coulston/Embedded-Systems-Instructor/hardware/daughterBoard/readme.md

# Ordering Process for Daughter Boards
Image of Embedded Development Daughter Board

This file outlines a procedure to order development boards from [JLCPCB](https://www.jlcpcb.com/).  
>[!NOTE] 
>These instructions referece manufacturer web pages that are not under my control.  As a 
result the web interfaces may be modified changing the look and feel of the interface.  In this
event, you will need to adapt the instructions to the current interface.

## Order from JLCPCB

1. Download [daughterBoardGerber.zip](Https://github.com/coulston/Embedded-Systems-Instructor/blob/main/hardware/daughterBoard/manufacture/daughterBoardGerber.zip) to your local drive
5. Sign In to [JLCPCB](https://www.jlcpcb.com/).
6. Click on the white Order Now button at the top of the page
7. Click on the blue Add gerber files button
8. In the pop-up, navigate and select daughterBoardGerber.zip you downloaded
9. Leave all the defaults along with the exception:
   - Quantity: Whatever you need
   - PCB Color: Blue has been the standard color
10. Click on the blue Add to Cart button
11. Click on the shopping cart icon at the top of the screen
12. Click the blue Secure Checkout button and proceed with payment and shipping.
13. You should hear back from the JLCPCB in 24 hours.
