coulston/Embedded-Systems-Instructor/hardware/devBoard/img/pcbWay05.PNG

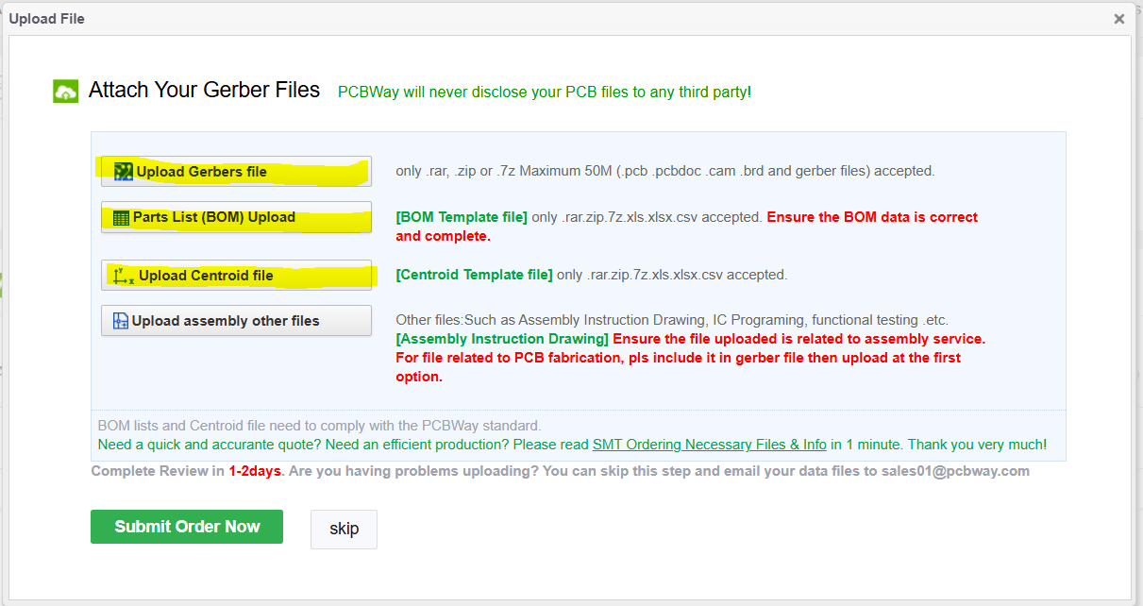
hardware/devBoard/img/pcbWay05.PNG
