coulston/Embedded-Systems-Instructor/hardware/devBoard/manufacture/devBoard BOM.xlsx

Value | Designator | Manufacture | Mnf Part # | Digikey Part | Foot |  | Number | SMT | Through | #SMT | #through
2.2 ohm | R2, R10 | Yageo | RC1206FR-072R2L | 311-2.20FRCT-ND | R1206 | $0.05 | 2 | 1 |  | 2 | 0
39 ohm | R1, R4, R13 | Panasonic | ERJ-8GEYJ390V | P39ECT-ND | R1206 | $0.03 | 3 | 1 |  | 3 | 0
100 ohms | R12 | Panasonic | ERJ-8GEYJ101V | P100ECT-ND | R1206 | $0.03 | 1 | 1 |  | 1 | 0
300 ohm | R8 | Panasonic | ERJ-8GEYJ301V | P300ECT-ND | R1206 | $0.03 | 1 | 1 |  | 1 | 0
910 ohm | R11, R14, R22 | Panasonic | ERJ-8GEYJ911V | P910ECT-ND | R1206 | $0.03 | 3 | 1 |  | 3 | 0
2.2k ohm | R3, R15, R16 | Panasonic | ERJ-8GEYJ222V | P2.20KFCT-ND | R1206 | $0.03 | 3 | 1 |  | 3 | 0
10k ohm | R5, R6, R7, R18, R19, R20, R21, R23 | Vishay Dale | CRCW120610K0FKEAC | 541-3983-1-ND | R1206 | $0.03 | 8 | 1 |  | 8 | 0
1M ohm | R9 | Panasonic | ERJ-8GEYJ105V | P1.0MECT-ND | R1206 | $0.03 | 1 | 1 |  | 1 | 0
 |  |  |  |  |  |  |  |  |  | 0 | 0
PTC fuse | F2 | LittleFuse | 1206L012WR | F2864CT-ND | R1206 | $0.33 | 1 | 1 |  | 1 | 0
47pF | C2, C4, C13 | Kemet | C1206C470K5GACTU | 399-8191-1-ND | C1206 | $0.06 | 3 | 1 |  | 3 | 0
0.1uF | C3, C5, C6, C8, C11, C14, C16, C17, C18 | Samsung | CL31B104KBCNNNC | 1276-1017-1-ND | C1206 | $0.03 | 9 | 1 |  | 9 | 0
1uF | C10, C15, C19 | Samsung | CL31B105KOFNNNE | 1276-1783-1-ND | C1206 | $0.05 | 3 | 1 |  | 3 | 0
10uF | C1, C7, C9, C12 | Samsung | CL31A106KQHNNNE | 1276-1079-1-ND | C1206 | $0.05 | 4 | 1 |  | 4 | 0
 |  |  |  |  |  |  |  |  |  | 0 | 0
M02LOCK | 5V, JP2, JP7, JP3 | Molex | 901200122 | WM8072-ND | 0.1" header | $0.78 | 4 |  | 1 | 0 | 4
M03LOCK | JP4 | Molex | 901200123 | WM8073-ND | 0.1" header | $0.78 | 1 |  | 1 | 0 | 1
M06LOCK | JP10, JP12 | Molex | 901200126 | WM8076-ND | 0.1" header | $0.74 | 2 |  | 1 | 0 | 2
Right | JP11 | FCI | 22288061 | WM50025-06-ND | 0.1" header | $1.14 | 1 |  | 1 | 0 | 1
Mini USB conn | X1 | Tyco | 1734035-2 | A31727CT-ND | Custom | $1.40 | 1 | 1 |  | 1 | 0
2x4 header | JP8, JP9 | FCI | 67997-108HLF | 609-3226-ND | 2x4 | $0.36 | 2 |  | 1 | 0 | 2
Tactile Switch SPST-NO Top Actuated Surface Mount | BOT, RESET, TOP | C&K | PTS526 SMG15 SMTR2 LFS | CKN12222-1-ND | 5.2mm | $0.08 | 3 | 1 |  | 3 | 0
Electric Mic | MICROPHONE | CUI | CMA-6542PF | 102-1720-ND | 9.7mm | $0.53 | 1 |  | 1 | 0 | 1
Terminal Block | SPEAKER | Phoenix Contact | part# 1725656 | 277-1273-ND | Custom | $1.47 | 1 |  | 1 | 0 | 1
 |  |  |  |  |  |  |  |  |  | 0 | 0
PIC 18F25K22 | PIC18F25K22 | Microchips | PIC18F25K22-I/SS | PIC18F25K22-I/SS-ND | 28-SSOP | $2.18 | 1 | 1 |  | 1 | 0
Serial USB bridge | IC2 | Future Tech | FT230XS-R | 768-1135-1-ND | 16-SSOP | $1.90 | 1 | 1 |  | 1 | 0
GP Opamp | IC1, IC4 | Texas | OPA344NA/250 | OPA344NACT-ND | SOT23-5 | $1.05 | 2 | 1 |  | 2 | 0
2N2222 NPN | Q1 | Diodes Incorporated | MMBT2222A-7-F | MMBT2222A-FDICT-ND | SOT-23 | $0.05 | 1 | 1 |  | 1 | 0
Linear Voltage Regulator IC 1 Output 250mA SOT-23A-3 | MCP1703 | Microchips | MCP1703T-3302E/CB | MCP1703T-3302E/CBCT-ND | SOT-23 | $0.41 | 1 | 1 |  | 1 | 0
Audio Amp | IC6 | TI | LM4862MX/NOPB | LM4862MX/NOPBCT-ND | 8 SOIC | $0.83 | 1 | 1 |  | 1 | 0
38kHz remote | IR1 | Vishay | TSOP34438 | TSOP34438-ND | custom | $0.70 | 1 | 1 |  | 1 | 0
Green SM | LED3 | Lite-On | LTST-C150GKT | 160-1169-1-ND | D1206 | $0.11 | 1 | 1 |  | 1 | 0
Red SM | LED6 | Lumex | SML-LX1206SRC-TR | 67-1359-1-ND | D1206 | $0.12 | 1 | 1 |  | 1 | 0
IR LED | LED5 | OSRAM | SFH 4045N | 475-3047-6-ND | D1206 | $0.37 | 1 | 1 |  | 1 | 0
RGB LED | LED4 | Cree | CLVBA-FKA-CAEDH8BBB7A363 | CLVBA-FKA-CAEDH8BBB7A363CT-ND | 4-PLCC | $0.36 | 1 | 1 |  | 1 | 0
Hall Effect | IC3 | Texas | DRV5053CAQDBZT | 296-46086-1-ND | SOT-23-3 | $0.86 | 1 | 1 |  | 1 | 0
 |  | 34 |  |  |  |  | 71 |  |  | 59 | 12
