coulston/Embedded-Systems-Instructor/hardware/devBoard/manufacture/devBoard BOM JLC.xlsx

Comment | Designator | Footprint | Part | Quantity
2.2 ohm | R2, R10 | 1206R | C2907445 | 1
39 ohm | R1, R4, R13 | 1206R | C25379 | 1
100 ohms | R12 | 1206R | C17901 | 1
300 ohm | R8 | 1206R | C17887 | 1
910 ohm | R11, R14, R22 | 1206R | C2930433 | 1
2.2k ohm | R3, R15, R16 | 1206R | C17948 | 1
10k ohm | R5, R6, R7, R18, R19, R20, R21, R23 | 1206R | C17902 | 1
1M ohm | R9 | 1206R | C17927 | 1
PTC fuse | F2 | 1206R | C883127 | 1
47pF | C2, C4, C13 | 1206C | C5137553 | 1
0.1uF | C3, C5, C6, C8, C11, C14, C16, C17, C18 | 1206C | C24497 | 1
1uF | C10, C15, C19 | 1206C | C1848 | 1
10uF | C1, C7, C9, C12 | 1206C | C13585 | 1
Tactile Switch SPST-NO Top Actuated Surface Mount | BOT, RESET, TOP | 5.2*5.2 | C5342990 | 1
USB | X1 | Custom | C91144 | 1
PIC 18F25K22 | PIC18F25K22 | SSOP-28 | C51680 | 1
Serial USB bridge | IC2 | SSOP-16 | C69082 | 1
GP Opamp | IC1, IC4 | SOT23-5 | C131974 | 1
2N2222 NPN | Q1 | SOT-23 |  | 1
Linear Voltage Regulator IC 1 Output 250mA SOT-23A-3 | MCP1703 | SOT-23 | C50754 | 1
Audio Amp | IC6 | SOIC-8 | C2860743 | 1
Green SM | LED3 | 1206D | C2984261 | 1
Red SM | LED6 | 1206D | C2984261 | 1
IR LED | LED5 | 1206D |  | 1
RGB LED | LED4 | PLCC-4 | C5355897 | 1
Hall Effect | IC3 | SOT-23-3 | C962159 | 1
