coulston/Embedded-Systems-Instructor/hardware/daughterBoard/manufacture/daughterBoard BOM.xlsx

Sheet: Digikey
DigiKey Order
Description | Manf | Manf Part # | DigiKey Part # | Foot | Unit Cost | Per Qty | Per Student | Bulk | Qty Need | Inventory | Order | Net Cost
1k ohm | Vishay Dale | CRCW12061K00FKEAC | 541-3980-1-ND | R1206 | $0.03 | 4 | $0.10 |  | 12 |  | 12 | $0.31
10k ohm | Vishay Dale | CRCW120610K0FKEAC | 541-3983-1-ND | R1206 | $0.03 | 3 | $0.08 |  | 9 |  | 9 | $0.25
0.1uF | Samsung | CL31B104JBCNNNC | 1276-1165-1-ND | C1206 | $0.03 | 1 | $0.03 |  | 3 |  | 3 | $0.10
10uF | Samsung | CL31A106KQHNNNE | 1276-1079-1-ND | C1206 | $0.05 | 1 | $0.05 |  | 3 |  | 3 | $0.15
Tactile Switch SPST-NO Top Actuated Surface Mount | C&K | PTS526 SMG15 SMTR2 LFS | CKN12222-1-ND | Custom | $0.10 | 3 | $0.31 |  | 9
Slide Switch SP3T Surface Mount, Right Angle | C&K | AYZ0103AGRLC | 401-2014-1-ND | Custom | $0.84 | 1 | $0.84 |  | 3 |  | 3 | $2.52
CONN HDR 6POS 0.1 TIN PCB | Sullins Connector Solutions | PPTC061LFBN-RC | S7004-ND | 6 pos header | $0.37 | 2 | $0.74 |  | 6 |  | 6 | $2.22
CONN HDR 8POS 0.1 TIN PCB | Sullins Connector Solutions | PPTC042LFBN-RC | S7072-ND | 2x4 pos header | $0.51 | 2 | $1.01 |  | 6 |  | 6 | $3.04
Spacer | Essentra Components | 13RS025092 | 145-13RS025092-ND | Custom | $0.07 | 3 | $0.21 |  | 9 |  | 9 | $0.62
#4-40 Pan Head Machine Screw Slotted Drive Steel | B&F Fastener Supply | PMS 440 0063 SL | H148-ND | 4-40 screw | $0.01 | 3 | $0.03 |  | 9
#4-40 Hex Nut 0.250" (6.35mm) 1/4" | B&F Fastener Supply | HNZ 440 | H216-ND | 4-40 nut | $0.01 | 3 | $0.03 |  | 9
Connector Header Surface Mount, Right Angle 2 position 0.079" (2.00mm) | JST Sales America Inc. | S2B-PH-SM4-TB(LF)(SN) | 455-1749-6-ND | JST2 | $0.45 | 1
Green SM | Lite-On | LTST-C150GKT | 160-1169-1-ND | D1206 | $0.11 | 2 | $0.22 |  | 6 |  | 6 | $0.65
Yellow | Lite-On | LTST-C150KSKT | 160-1406-1-ND | D1206 | $0.11 | 1 | $0.11 |  | 3 |  | 3 | $0.33
Red SM | Lite-On | LTST-C150CKT | 160-1167-1-ND | D1206 | $0.12 | 1 | $0.12 |  | 3 |  | 3 | $0.37
Linear Voltage Regulator IC Positive Fixed 1 Output 150mA SOT-23-5 | Micrel | MIC5205-3.3YM5 TR | 576-1259-1-ND | SOT23-5 | $0.42 | 1
Linear Voltage Regulator IC Positive Fixed 1 Output 200mA SOT-23 | Torex Semiconductor Ltd | XC6206P332MR-G | XC6206P332MR-G-ND | SOT23
 |  | MCP73831
Charger IC Lithium Ion TSOT-23-5 | Analog Devices Inc. | LTC4054ES5-4.2#TRMPBF | LTC4054ES5-4.2#TRMPBFCT-ND | SOT23-5 | $2.87 | 1
Charger IC Lithium Ion TSOT-23-5 | STMicroelectronics | STC4054GR | 497-5809-1-ND | SOT23-5 | $1.20 | 1
GY521 |  |  |  |  |  | 1
Purchase | 3 |  | Parts |  | $3.89 | 1 | $3.89 |  | 3 |  | 3 | $10.25

Sheet: AliExpress
DigiKey Order
Description | Manf | Pcs / Order | Foot | Cost | Per Qty | Per Student | Inventory | Order | Net Cost
2.2k ohm | link (https://www.aliexpress.com/item/32847115923.html?spm=a2g0o.detail.1000023.6.4ccc5890SBA9vw) | 100 | R1206 | $0.45 | 9 | $0.04 |  | 18 | $8.10
10uF | link (https://www.aliexpress.com/item/4001289480699.html) | 100 | C1206 | $1.35 | 2 | $0.03 |  | 4 | $5.40
Tactile Switch SPST-NO Top Actuated Surface Mount H=2.3 | link (https://www.aliexpress.com/item/1068215251.html) | 50 | Custom | $0.88 | 3 | $0.05 |  | 12 | $10.56
Slide Switch SP3T Surface Mount, Right Angle | link (https://www.aliexpress.com/item/1005002974022339.html) | 100 | Custom | $3.84 | 1 | $0.04 |  | 2 | $7.68
CONN HDR 2POS 0.1 TIN PCB | link (https://www.aliexpress.com/item/32392631192.html) | 100 | 2 pos header | $9.50 | 1 | $0.10 |  | 2 | $19.00
CONN HDR 6POS 0.1 TIN PCB | link (https://www.aliexpress.com/item/32392631192.html) | 100 | 6 pos header | $10.30 | 2 | $0.21 |  | 4 | $41.20
CONN HDR 8POS 0.1 TIN PCB | link (https://www.aliexpress.com/item/32982421676.html) | 50 | 2x4 pos header | $1.52 | 1 | $0.03 |  | 4 | $6.08
Spacer 11mm, M3, White | link (https://www.aliexpress.com/item/32955606430.html) | 50 | Custom | $4.40 | 3 | $0.26 |  | 12 | $52.80
M3 screw, white 5mm | link (https://www.aliexpress.com/item/32967298736.html?pdp_ext_f=%7B%22sku_id%22%3A%2266645096831%22%7D) | 50 | M3 screw | $0.68 | 3 | $0.04 |  | 12 | $8.16
M3 nut white | link (https://www.aliexpress.com/item/32855383443.html) | 100 | M3 nut | $2.56 | 3 | $0.08 |  | 6 | $15.36
Green SM | link (https://www.aliexpress.com/item/2031685194.html?pdp_ext_f=%7B%22sku_id%22%3A%2265106616640%22%7D) | 100 | D1206 | $0.60 | 3 | $0.02 |  | 6 | $3.60
Yellow | link (https://www.aliexpress.com/item/2031685194.html?pdp_ext_f=%7B%22sku_id%22%3A%2265106616640%22%7D) | 100 | D1206 | $0.60 | 1 | $0.01 |  | 2 | $1.20
Red SM | link (https://www.aliexpress.com/item/2031685194.html?pdp_ext_f=%7B%22sku_id%22%3A%2265106616640%22%7D) | 100 | D1206 | $0.60 | 1 | $0.01 |  | 2 | $1.20
MCP73831T-2DCI/OT | link (https://www.aliexpress.com/item/32958433167.html?pdp_ext_f=%7B%22sku_id%22%3A%2266415343963%22%7D) | 100 | SOT23-5 | $5.10 | 1 | $0.05 |  | 1 | $5.10
GY521 | link (https://www.aliexpress.com/item/1005001864385331.html?scm_id=1007.33416.213724.0&scm-url=1007.33416.213724.0) | 10 | Custom | $11.20 | 1 | $1.12 |  | 20 | $224.00
2pin JST | link (https://www.aliexpress.com/item/1005003221061447.html) | 100 | Custom | $28.00 | 1 | $0.28 |  | 2 | $56.00
H36 3.7v 150mah 30C LIPO Battery | link (https://www.aliexpress.com/item/4000146593141.html) | 100 | Custom | $107.68 | 1 | $1.08 |  | 2 | $215.36
Purchase |  |  |  | $3.43 | 1 | $3.43 |  |  | $672.70
200
