coulston/Embedded-Systems-Instructor/hardware/devBoard/testing/img/PXL_20230522_024632017.jpg

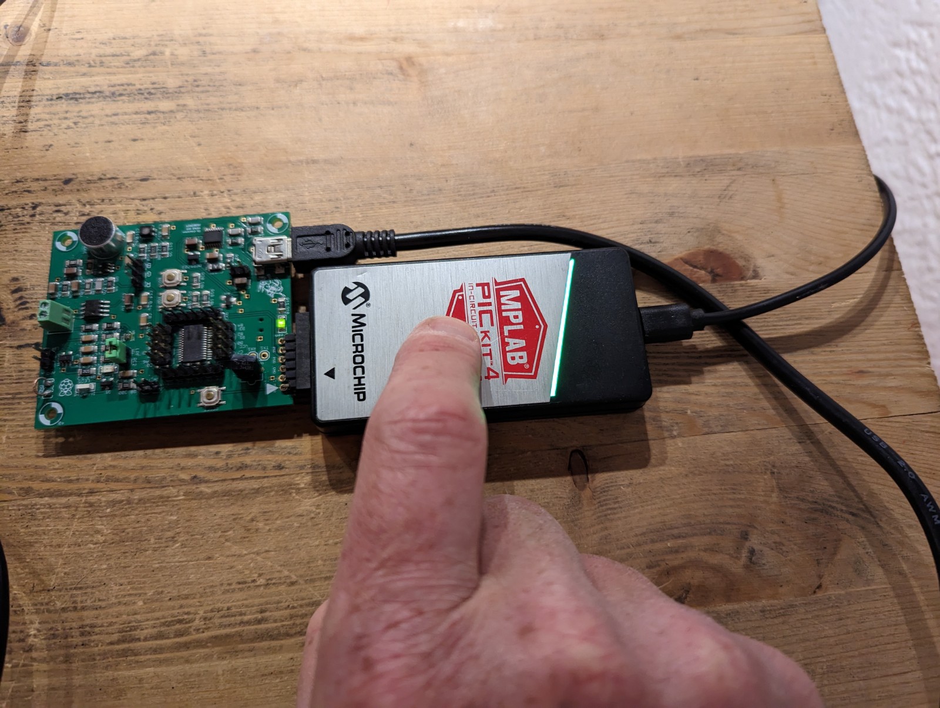
hardware/devBoard/testing/img/PXL_20230522_024632017.jpg
