coulston/Embedded-Systems-Instructor/hardware/devBoard/testing/img/PXL_20230522_025110916.jpg

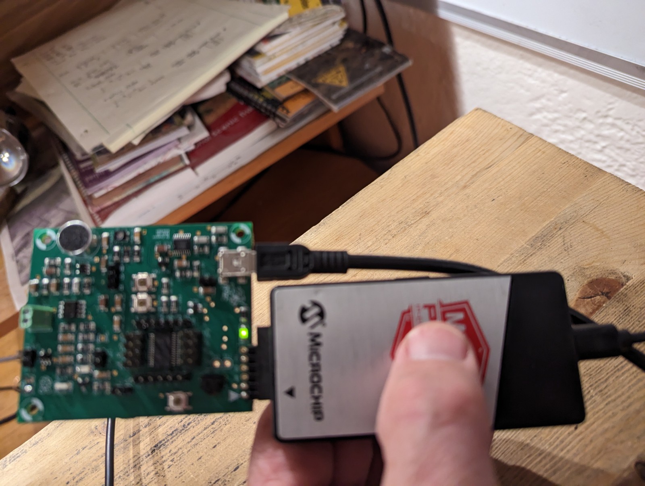
hardware/devBoard/testing/img/PXL_20230522_025110916.jpg
