coulston/Embedded-Systems-Instructor/hardware/devBoard/testing/img/PXL_20230522_025114191.jpg

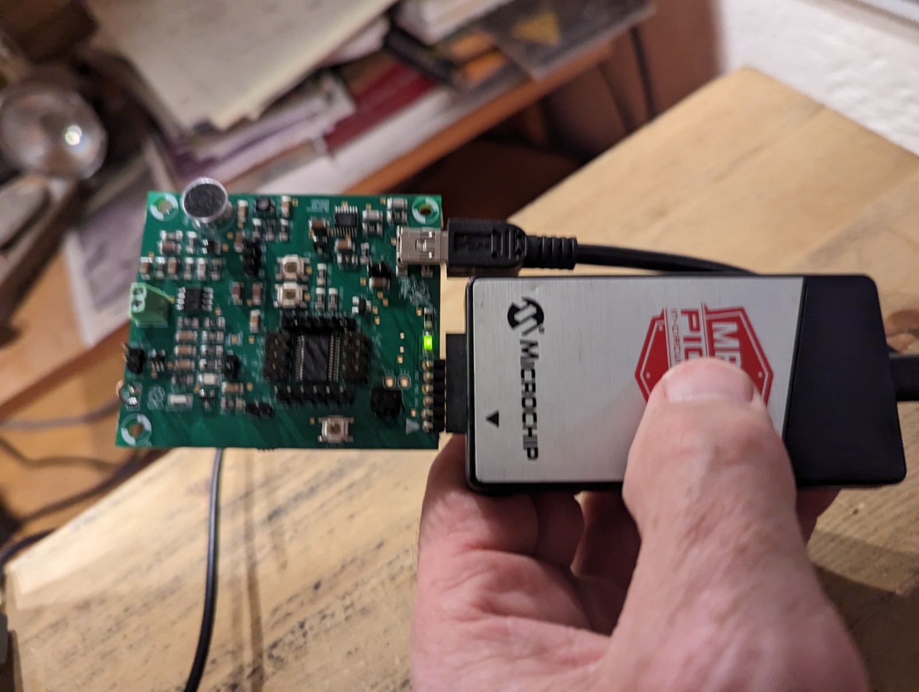
hardware/devBoard/testing/img/PXL_20230522_025114191.jpg
