coulston/Embedded-Systems-Instructor/hardware/devBoard/src/dev21schematic.pdf

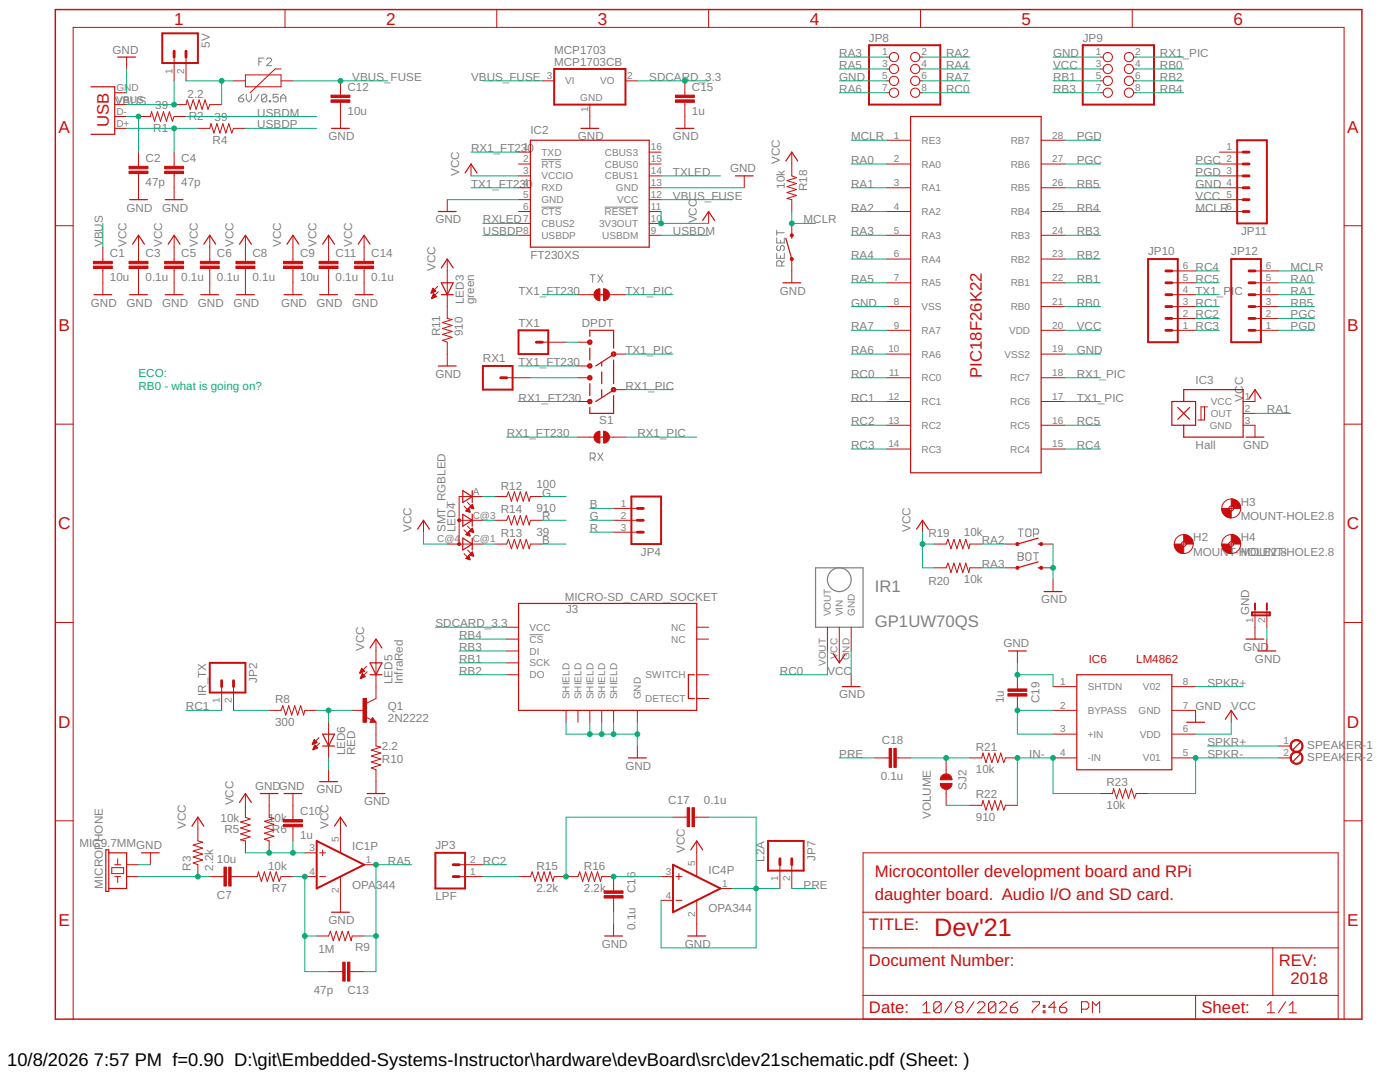
[picture p28: page 1]

ECO: RB0 - what is going on?

Microcontoller development board and RPi
Dev'21

10/8/2026 7:57 PM f=0.90 D:\git\Embedded-Systems-Instructor\hardware\devBoard\src\dev21schematic.pdf (Sheet: )
