coulston/Embedded-Systems-Instructor/hardware/devBoard/src/dev21layout.pdf

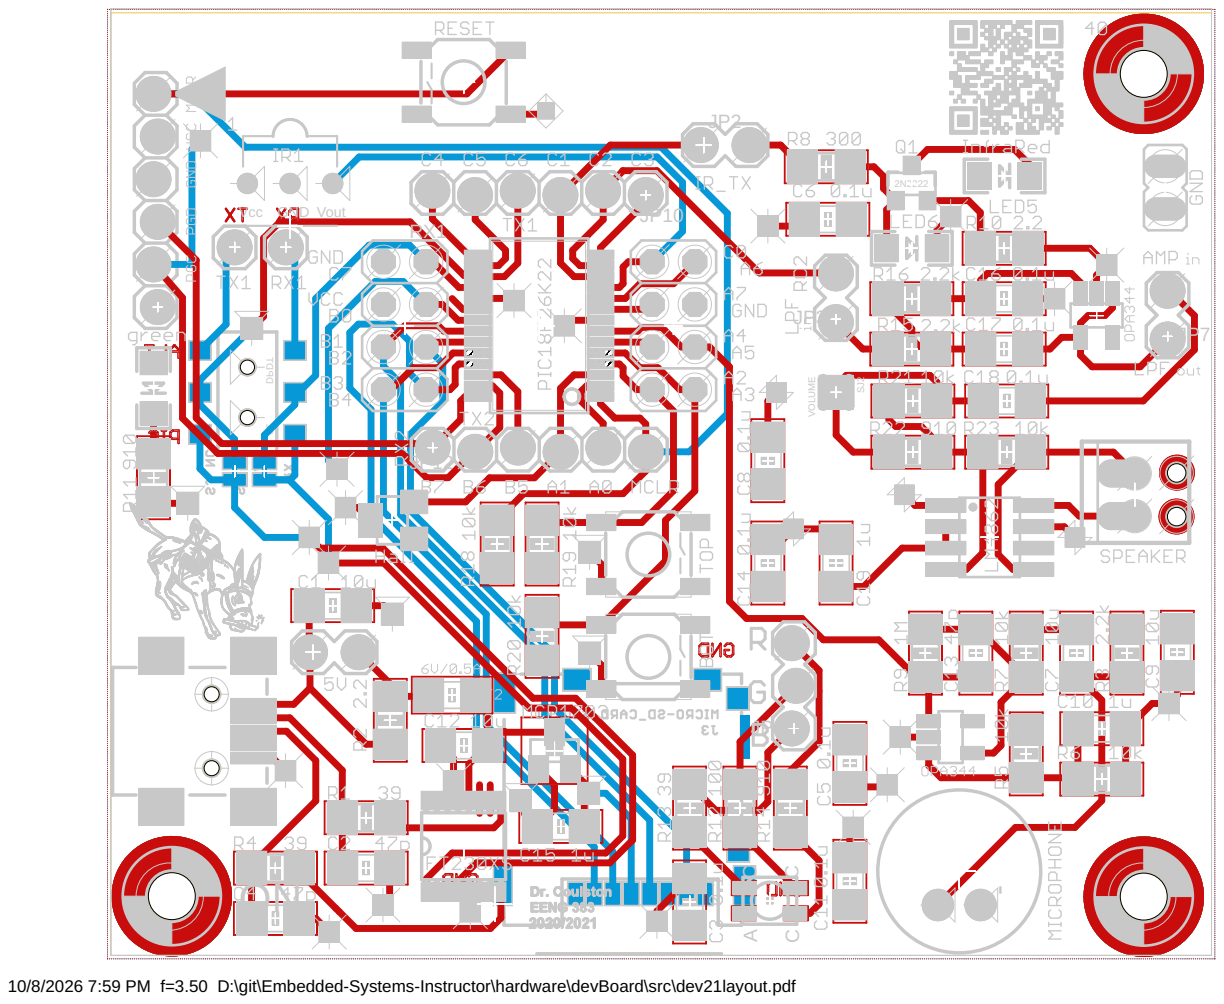
[picture p29: page 1]

10/8/2026 7:59 PM f=3.50 D:\git\Embedded-Systems-Instructor\hardware\devBoard\src\dev21layout.pdf
