coulston/Embedded-Systems-Instructor/hardware/devBoard/src/devBoard.brd

## EAGLE design hardware/devBoard/src/devBoard.brd (2026-10-09)

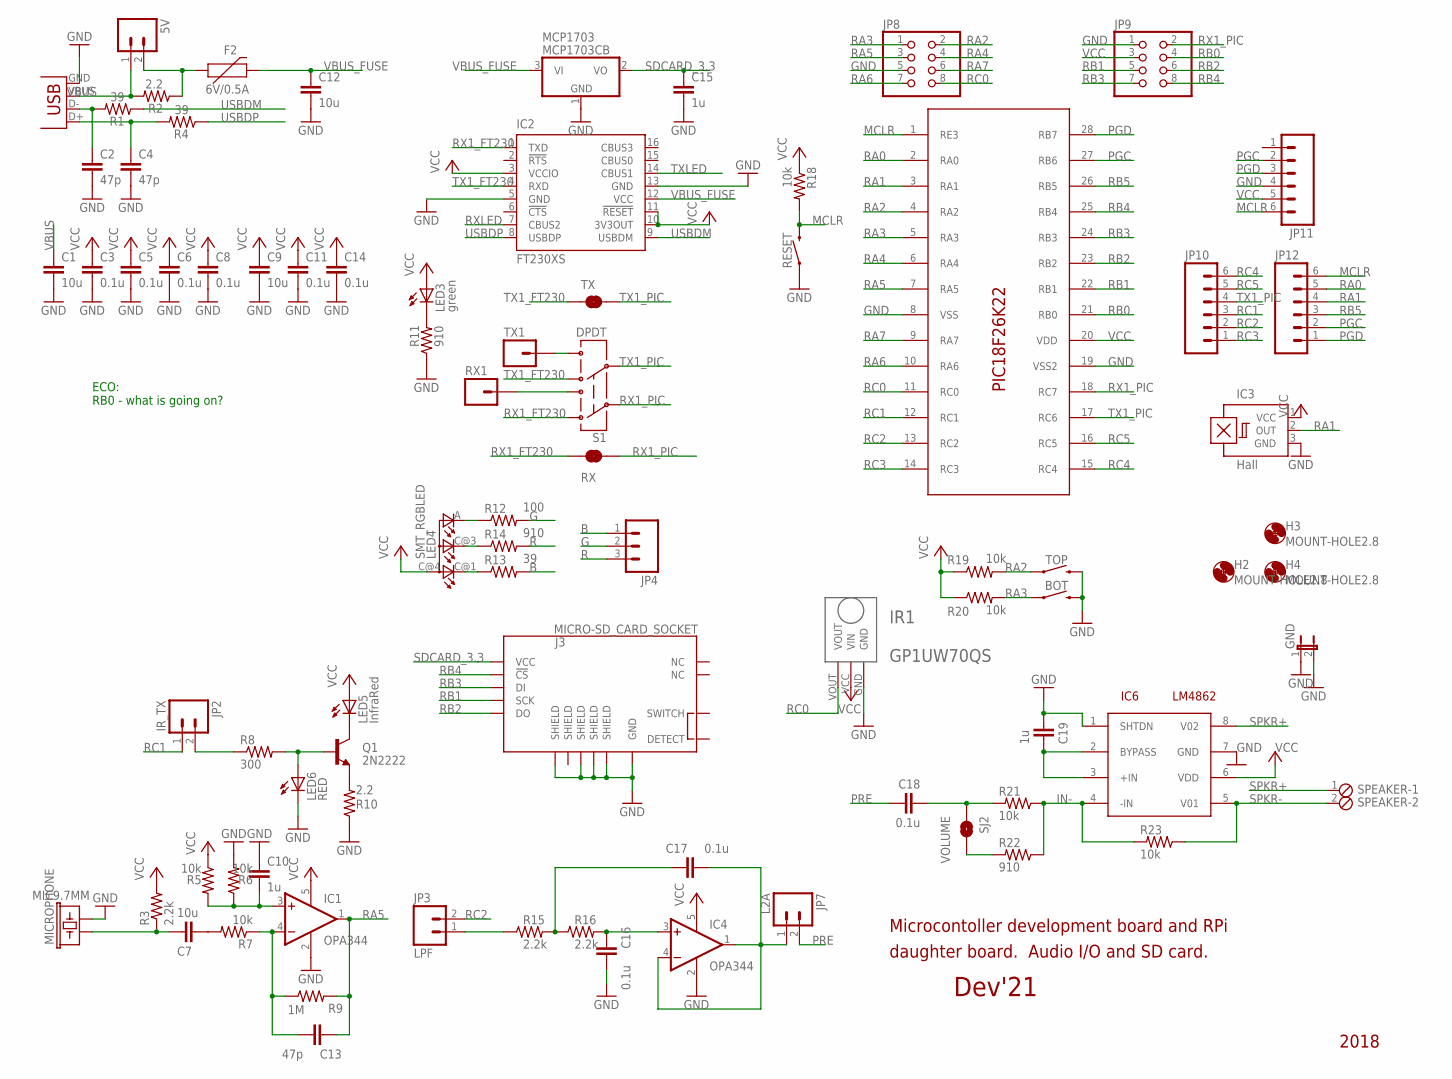
[picture p30: schematic devBoard.sch]

Parts:
5V: M02LOCK; 1X02_LOCK
BOT: MOMENTARY-SWITCH-SPST-SMD-5.2MM; TACTILE_SWITCH_SMD_5.2MM
C1, C7, C9, C12: 10u; C1206
C2, C4, C13: 47p; C1206
C3, C5, C6, C8, C11, C14, C16, C17, C18: 0.1u; C1206
C10, C15, C19: 1u; C1206
F2: 6V/0.5A; 1206
GND: JP1E; JP1
H2, H3, H4: MOUNT-HOLE2.8; 2,8
IC1, IC4: OPA344; SOT23-5
IC2: FT230XS; SSOP16
IC3: Hall; SOT23-W
IC6: LM4862; SO08
IR1: GP1UW70QS
J3: MICRO-SD_CARD_SOCKET; MICRO-SD-SOCKET
JP2: IR_TX; 1X02_LOCK
JP3: LPF; 1X02_LOCK
JP4: M03LOCK; 1X03_LOCK
JP7: L2A; 1X02_LOCK
JP8, JP9: PINHD-2X4; 2X04
JP10, JP11, JP12: M06LOCK; 1X06_LOCK
LED3: green; LED-1206
LED4: SMT_RGBLED; P-LCC-4
LED5: InfraRed; LED-1206
LED6: RED; LED-1206
MCP1703: MCP1703CB; SOT23
MICROPHONE: MIC9.7MM; MIC-9.7MM
PIC18F26K22: PIC18F26J2228SSOP; SSOP28DB
Q1: 2N2222; SOT23-3
R1, R4, R13: 39; R1206
R2, R10: 2.2; R1206
R3, R15, R16: 2.2k; R1206
R5, R6, R7, R18, R19, R20, R21, R23: 10k; R1206
R8: 300; R1206
R9: 1M; R1206
R11, R14, R22: 910; R1206
R12: 100; R1206
RESET: MOMENTARY-SWITCH-SPST-SMD-5.2MM; TACTILE_SWITCH_SMD_5.2MM
RX: SJ_NC; SMT-JUMPER_2_NC_TRACE_NO-SILK
RX1: M01PTH; 1X01
S1: DPDT; AYZ0202
SJ2: VOLUME; SJ_2S-NOTRACE
SPEAKER: MPT2; 2POL254
TOP: MOMENTARY-SWITCH-SPST-SMD-5.2MM; TACTILE_SWITCH_SMD_5.2MM
TX: SJ_NC; SMT-JUMPER_2_NC_TRACE_NO-SILK
TX1: M01PTH; 1X01
X1: USBSMD; USB-MINIB

Connections:
B: JP4.1, R13.2
G: JP4.2, R12.2
GND: BOT.3 (2), C1.2, C2.2, C3.2, C4.2, C5.2, C6.2, C8.2, C9.2, C10.1, C11.2, C12.2, C14.2, C15.2, C16.1, C19.2, GND.1, GND.2, IC1.2 (V-), IC2.5 (GND), IC2.13 (GND), IC3.3 (GND), IC4.2 (V-), IC6.1 (SHTDN), IC6.7 (GND), IR1.GND, J3.GND, J3.SHIELD1 (SHIELD), J3.SHIELD3 (SHIELD), J3.SHIELD4 (SHIELD), J3.SHIELD5 (SHIELD), JP8.5, JP9.1, JP11.4, LED6.C, MCP1703.1 (GND), MICROPHONE.2, PIC18F26K22.8 (VSS), PIC18F26K22.19 (VSS2), R6.2, R10.1, R11.1, RESET.1, TOP.3 (2), X1.GND
IN-: IC6.4 (-IN), R21.1, R22.1, R23.2
MCLR: JP11.6, JP12.6, PIC18F26K22.1 (RE3), R18.2, RESET.3 (2)
MIC: C13.1, IC1.4 (-IN), R7.1, R9.1
unnamed: C16.2, IC4.3 (+IN), R16.2
unnamed: C17.2, R15.2, R16.1
unnamed: C17.1, IC4.1 (OUT), IC4.4 (-IN), JP7.1
unnamed: JP3.1, R15.1
unnamed: LED4.C@3 (CBLUE), R14.1
unnamed: C2.1, R1.2, X1.D-
unnamed: C4.1, R4.2, X1.D+
unnamed: C7.1, MICROPHONE.1, R3.1
unnamed: C7.2, R7.2
unnamed: 5V.2, F2.1, R2.1
unnamed: C10.2, IC1.3 (+IN), R5.2, R6.1
unnamed: RX1.1, S1.3
unnamed: LED4.C@1 (CRED), R13.1
unnamed: LED4.A (CGREEN), R12.1
unnamed: LED5.C, Q1.3 (C)
unnamed: LED3.C, R11.2
unnamed: Q1.2 (E), R10.2
unnamed: LED6.A, Q1.1 (B), R8.2
unnamed: C19.1, IC6.2 (BYPASS), IC6.3 (+IN)
unnamed: JP2.2, R8.1
unnamed: S1.6, TX1.1
unnamed: C18.1, R21.2, SJ2.1
unnamed: R22.2, SJ2.2
PGC: JP11.2, JP12.2, PIC18F26K22.27 (RB6)
PGD: JP11.3, JP12.1, PIC18F26K22.28 (RB7)
PRE: C18.2, JP7.2
R: JP4.3, R14.2
RA0: JP12.5, PIC18F26K22.2 (RA0)
RA1: IC3.2 (OUT), JP12.4, PIC18F26K22.3 (RA1)
RA2: JP8.2, PIC18F26K22.4 (RA2), R19.2, TOP.1
RA3: BOT.1, JP8.1, PIC18F26K22.5 (RA3), R20.2
RA4: JP8.4, PIC18F26K22.6 (RA4)
RA5: C13.2, IC1.1 (OUT), JP8.3, PIC18F26K22.7 (RA5), R9.2
RA6: JP8.7, PIC18F26K22.10 (RA6)
RA7: JP8.6, PIC18F26K22.9 (RA7)
RB0: JP9.4, PIC18F26K22.21 (RB0)
RB1: J3.SCLK (SCK), JP9.5, PIC18F26K22.22 (RB1)
RB2: J3.DO, JP9.6, PIC18F26K22.23 (RB2)
RB3: J3.DI, JP9.7, PIC18F26K22.24 (RB3)
RB4: J3.CS (!CS), JP9.8, PIC18F26K22.25 (RB4)
RB5: JP12.3, PIC18F26K22.26 (RB5)
RC0: IR1.VOUT, JP8.8, PIC18F26K22.11 (RC0)
RC1: JP2.1, JP10.3, PIC18F26K22.12 (RC1)
RC2: JP3.2, JP10.2, PIC18F26K22.13 (RC2)
RC3: JP10.1, PIC18F26K22.14 (RC3)
RC4: JP10.6, PIC18F26K22.15 (RC4)
RC5: JP10.5, PIC18F26K22.16 (RC5)
RX1_FT230: IC2.1 (TXD), RX.1, S1.1
RX1_PIC: JP9.2, PIC18F26K22.18 (RC7), RX.2, S1.2
RXLED: IC2.7 (CBUS2)
SDCARD_3.3: C15.1, J3.VCC, MCP1703.2 (VO)
SPKR+: IC6.8 (V02), SPEAKER.1
SPKR-: IC6.5 (V01), R23.1, SPEAKER.2
TX1_FT230: IC2.4 (RXD), S1.4, TX.1
TX1_PIC: JP10.4, PIC18F26K22.17 (RC6), S1.5, TX.2
TXLED: IC2.14 (CBUS1)
USBDM: IC2.9 (USBDM), R1.1
USBDP: IC2.8 (USBDP), R4.1
VBUS: 5V.1, C1.1, R2.2, X1.VBUS
VBUS_FUSE: C12.1, F2.2, IC2.12 (VCC), MCP1703.3 (VI)
VCC: C3.1, C5.1, C6.1, C8.1, C9.1, C11.1, C14.1, IC1.5 (V+), IC2.3 (VCCIO), IC2.10 (3V3OUT), IC2.11 (!RESET), IC3.1 (VCC), IC4.5 (V+), IC6.6 (VDD), IR1.VCC (VIN), JP9.3, JP11.5, LED3.A, LED4.C@4 (A), LED5.A, PIC18F26K22.20 (VDD), R3.2, R5.1, R18.1, R19.1, R20.1

Notes on the sheet:
Microcontoller development board and RPi
daughter board. Audio I/O and SD card.
2018
Dev'21
ECO: RB0 - what is going on?

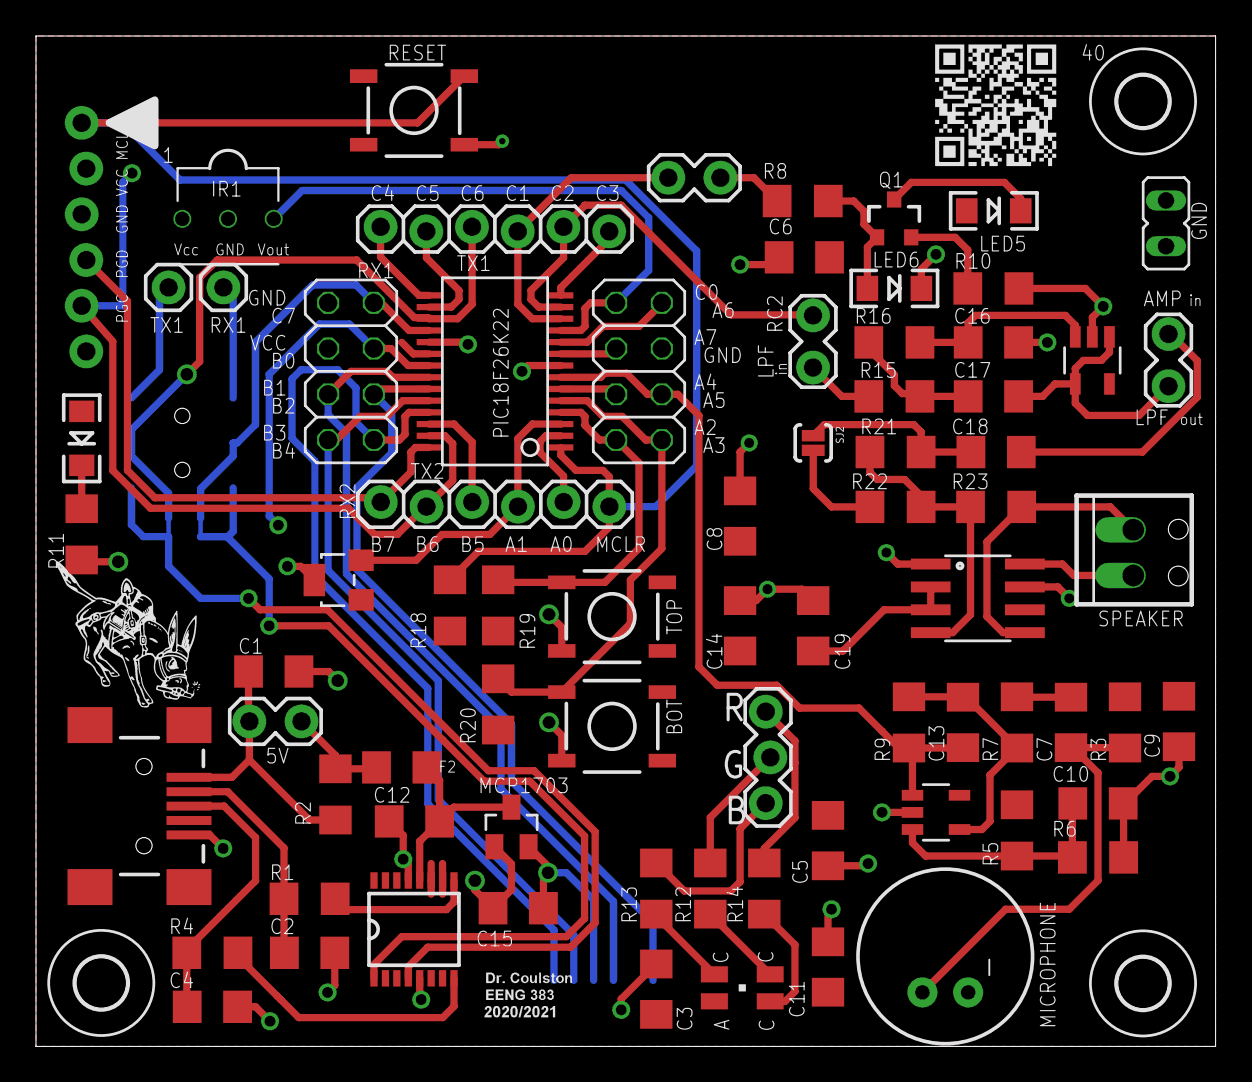
[picture p31: board devBoard.brd from above]

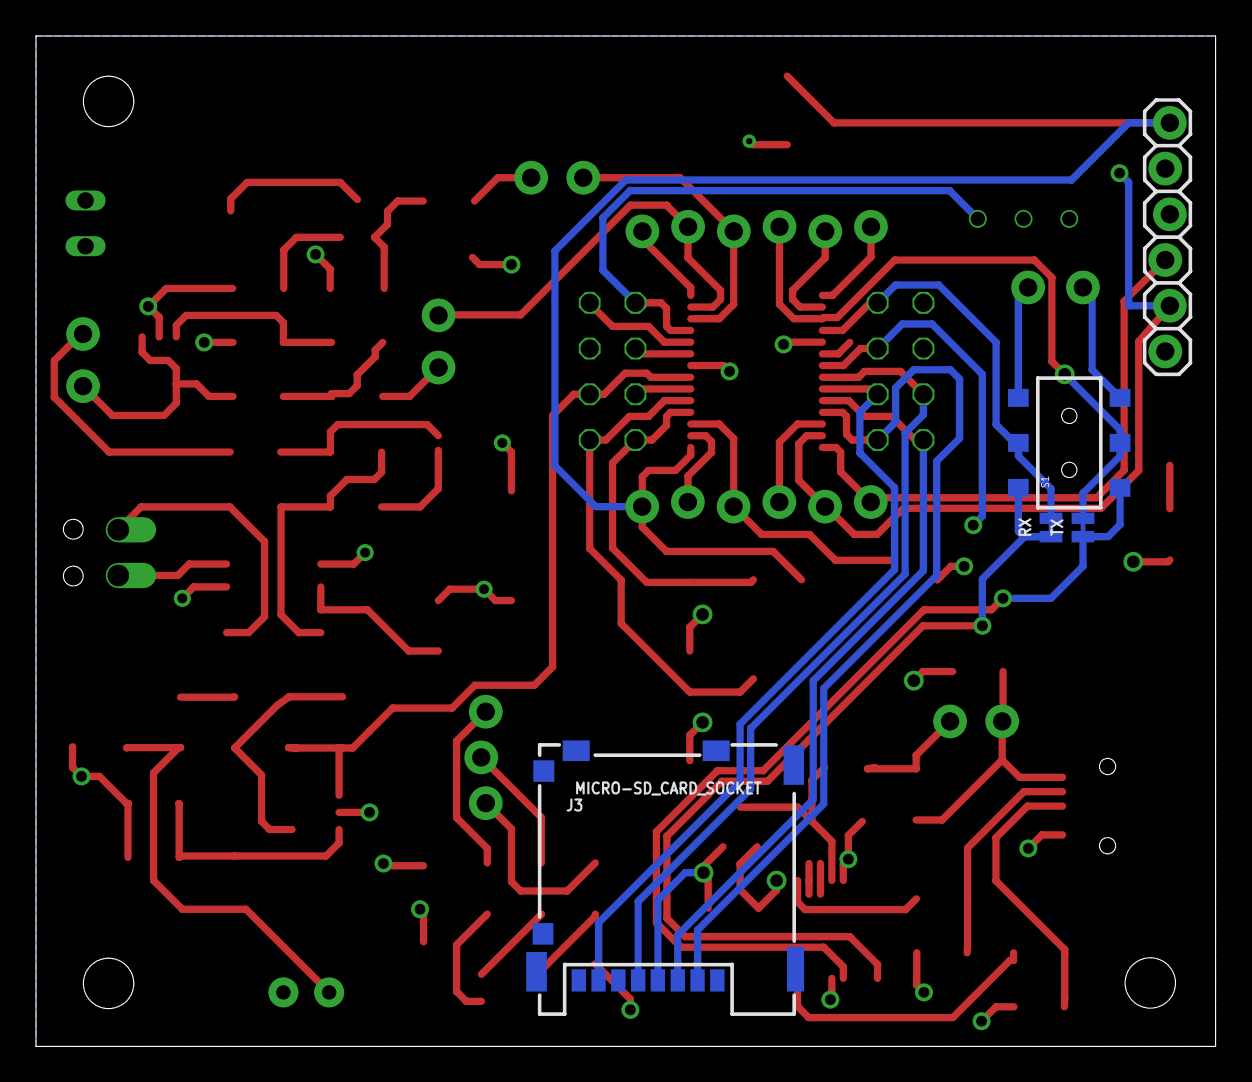
[picture p32: board devBoard.brd from below]

Board: 2 copper layers, 65.5 x 56.1 mm, 82 parts (5 on the bottom side), 65 nets.
