coulston/Embedded-Systems-Instructor/hardware/daughterBoard/src/daughterBoard.brd

## EAGLE design hardware/daughterBoard/src/daughterBoard.brd (2026-04-20)

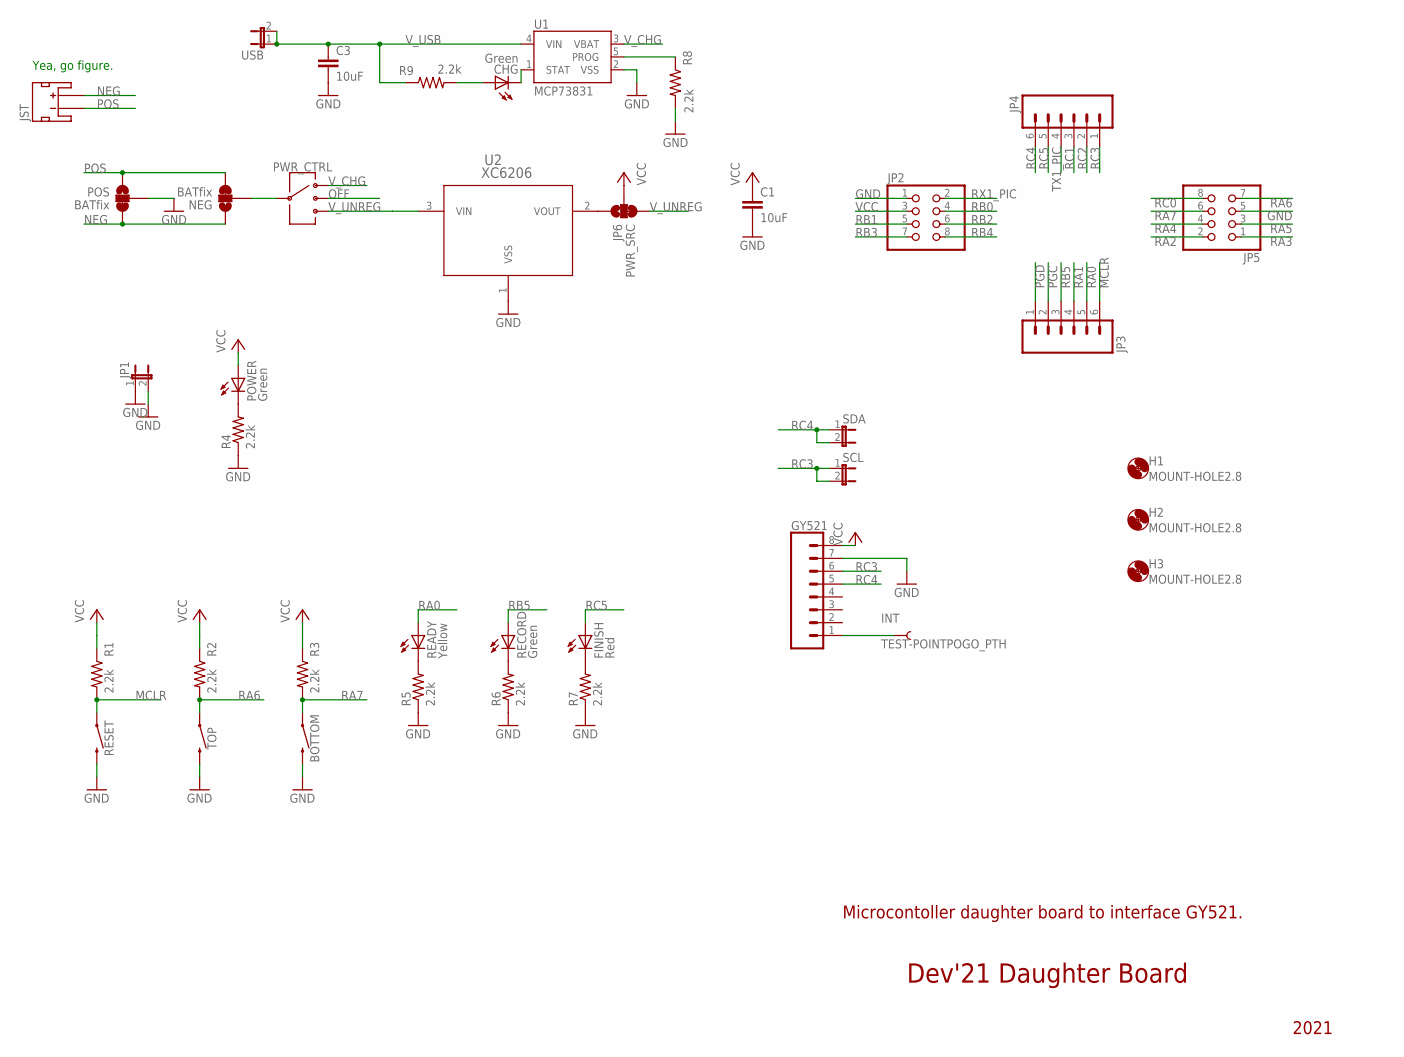
[picture p33: schematic daughterBoard.sch]

Parts:
BOTTOM: BOTTOM; TACTILE_SWITCH_SMD_5.2MM
C1, C3: 10uF; C1206
CHG: Green; LED-1206
FINISH: Red; LED-1206
GY521: CONN_08LOCK_LONGPADS; 1X08_LOCK_LONGPADS
H1, H2, H3: MOUNT-HOLE2.8; 2,8
INT: TEST-POINTPOGO_PTH; 1X01_NO_SILK
JP1: JP1E; JP1
JP2, JP5: PINHD-2X4; 2X04
JP3, JP4: M06LOCK; 1X06_LOCK
JP6: PWR_SRC; SMT-JUMPER_3_1-NC_TRACE_SILK
JST: JST_2MM_MALE; JST-2-SMD
NEG: BATfix; SMT-JUMPER_3_1-NC_TRACE_SILK
POS: BATfix; SMT-JUMPER_3_1-NC_TRACE_SILK
POWER: Green; LED-1206
PWR_CTRL: SWITCH-SP3T-SMD; SWITCH_SP3T_SMD
R1, R2, R3, R4, R5, R6, R7, R8, R9: 2.2k; R1206
READY: Yellow; LED-1206
RECORD: Green; LED-1206
RESET: RESET; TACTILE_SWITCH_SMD_5.2MM
SCL: JUMPER-2PTH_LOCK; 1X02_LOCK
SDA: JUMPER-2PTH_LOCK; 1X02_LOCK
TOP: TOP; TACTILE_SWITCH_SMD_5.2MM
U1: MCP73831; SOT23-5
U2: XC6206; SOT-23_TOR-M
USB: JUMPER-2PTH_LOCK; 1X02_LOCK

Connections:
GND: BOTTOM.3 (2), C1.2, C3.2, GY521.7, JP1.1, JP1.2, JP2.1, JP5.5, POS.2, R4.1, R5.1, R6.1, R7.1, R8.2, RESET.3 (2), TOP.3 (2), U1.2 (VSS), U2.1 (VSS)
MCLR: JP3.6, R1.2, RESET.1
unnamed: NEG.2, PWR_CTRL.3
unnamed: R6.2, RECORD.C
unnamed: R5.2, READY.C
unnamed: FINISH.C, R7.2
unnamed: POWER.C, R4.2
unnamed: GY521.1, INT.1
unnamed: JP6.1, U2.2 (VOUT)
unnamed: CHG.A, R9.2
unnamed: R8.1, U1.5 (PROG)
unnamed: CHG.C, U1.1 (STAT)
NEG: JST.2 (+), NEG.1, POS.3
OFF: PWR_CTRL.2
PGC: JP3.2
PGD: JP3.1
POS: JST.1 (-), NEG.3, POS.1
RA0: JP3.5, READY.A
RA1: JP3.4
RA2: JP5.2
RA3: JP5.1
RA4: JP5.4
RA5: JP5.3
RA6: JP5.7, R2.2, TOP.1
RA7: BOTTOM.1, JP5.6, R3.2
RB0: JP2.4
RB1: JP2.5
RB2: JP2.6
RB3: JP2.7
RB4: JP2.8
RB5: JP3.3, RECORD.A
RC0: JP5.8
RC1: JP4.3
RC2: JP4.2
RC3: GY521.6, JP4.1, SCL.1, SCL.2
RC4: GY521.5, JP4.6, SDA.1, SDA.2
RC5: FINISH.A, JP4.5
RX1_PIC: JP2.2
TX1_PIC: JP4.4
VCC: C1.1, GY521.8, JP2.3, JP6.2, POWER.A, R1.1, R2.1, R3.1
V_CHG: PWR_CTRL.1, U1.3 (VBAT)
V_UNREG: JP6.3, PWR_CTRL.4, U2.3 (VIN)
V_USB: C3.1, R9.1, U1.4 (VIN), USB.1, USB.2

Notes on the sheet:
Microcontoller daughter board to interface GY521.
2021
Dev'21 Daughter Board
Yea, go figure.

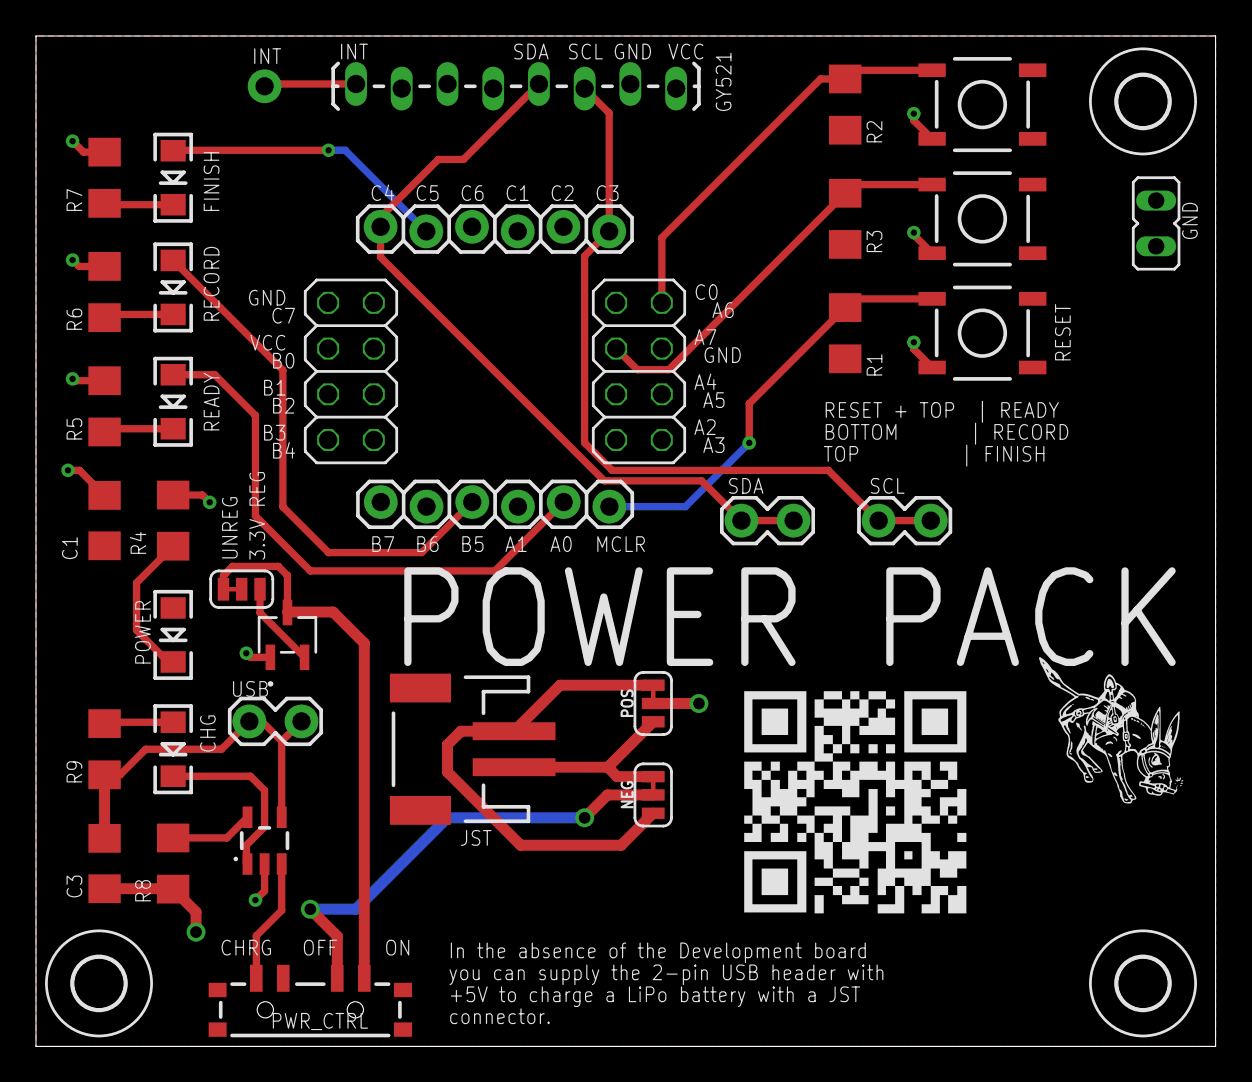
[picture p34: board daughterBoard.brd from above]

Board: 2 copper layers, 65.5 x 56.1 mm, 39 parts (0 on the bottom side), 25 nets.
