coulston/Embedded-Systems-Instructor/(commit log)

2025-06-04 Added Manufacturing Files
    [devBoard BOM PCBWay.xlsx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]
2025-06-04 Create README.md
    Walks users through the process of ordering assembled development boards from PCBWay
2025-06-04 pcbWay images to Order
    [devBoard BOM PCBWay.xlsx]
2025-06-04 some updates
    [devBoard BOM PCBWay.xlsx, devBoard BOM.xlsx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]
2025-06-05 Added Daughter Board
    Cleared up directory structure and added daughter board folder and files
    [daughterBoard BOM.xlsx, daughterBoard.brd, daughterBoard.sch, devBoard BOM JLC.xlsx, devBoard BOM.xlsx, devBoard.brd, devBoard.sch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]
2025-06-05 Create .gitignore
    Ignore for EAGLE CAD revision files
2025-06-05 Create .gitignore
    EAGLE CAD backup files
2025-06-05 Added cam and dru
    added files so that you can remake the gerber files using the same set of design rules and layers
2025-06-05 update gerber file names
    [devBoard BOM JLC.xlsx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]
2025-06-06 updating BOM
    Will stop this until I get the SD Card information
    [devBoard BOM JLC.xlsx, devBoard BOM.xlsx]
2025-06-12 Update devBoard BOM.xlsx
    Removed the LCSC and JLCPCB columns from the inclusive page. Removed other pages from the BOM.
    [devBoard BOM.xlsx]
2025-06-16 Update devBoard BOM.xlsx
    Change the number of 0.l1uF capacitors to 9 instead of the listed 7.
    [devBoard BOM.xlsx]
2025-07-10 Update devBoard CPL.xlsx
    Added the positions for the SMT parts in a second tab.
    [devBoard CPL.xlsx]
2025-10-06 Add PPT
    Created by Hisham Sager based on the course materials created by Christopher Coulston
2026-04-20 Added QR code
    Added coulston.github.io QR code to the Daughter board
2026-04-20 Updated the source files
    [daughterBoard.brd, daughterBoard.sch]
2026-10-09 updated QR code to gitHub URL
    [devBoard.brd, devBoard.sch]
